stav98/UrsaMinor_CanSat-2018/Calculations/design2.jpg

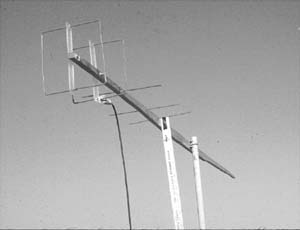
Calculations/design2.jpg
