stav98/UrsaMinor_CanSat-2018/Readme.md

Arduino folder contains nesessary libraries and hardware boads for compilation
Calculations folder contains spreadsheet calculations for parachute, antenna etc.
