stav98/UrsaMinor_CanSat-2018/Arduino/Readme.md

This is Arduino subfolder of MyDocuments folder. Unzip and append libraries and hardware folders.
To compile use tools/board MightyCore ATMEGA 1284 Board.
