stav98/UrsaMinor_CanSat-2018/Calculations/8lq.jpg

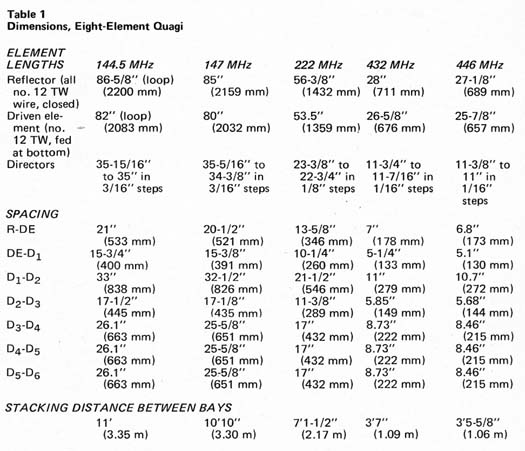
Calculations/8lq.jpg
