stav98/UrsaMinor_CanSat-2018/schematics/basestation.sch

## EAGLE design schematics/basestation.sch (2018-09-28)

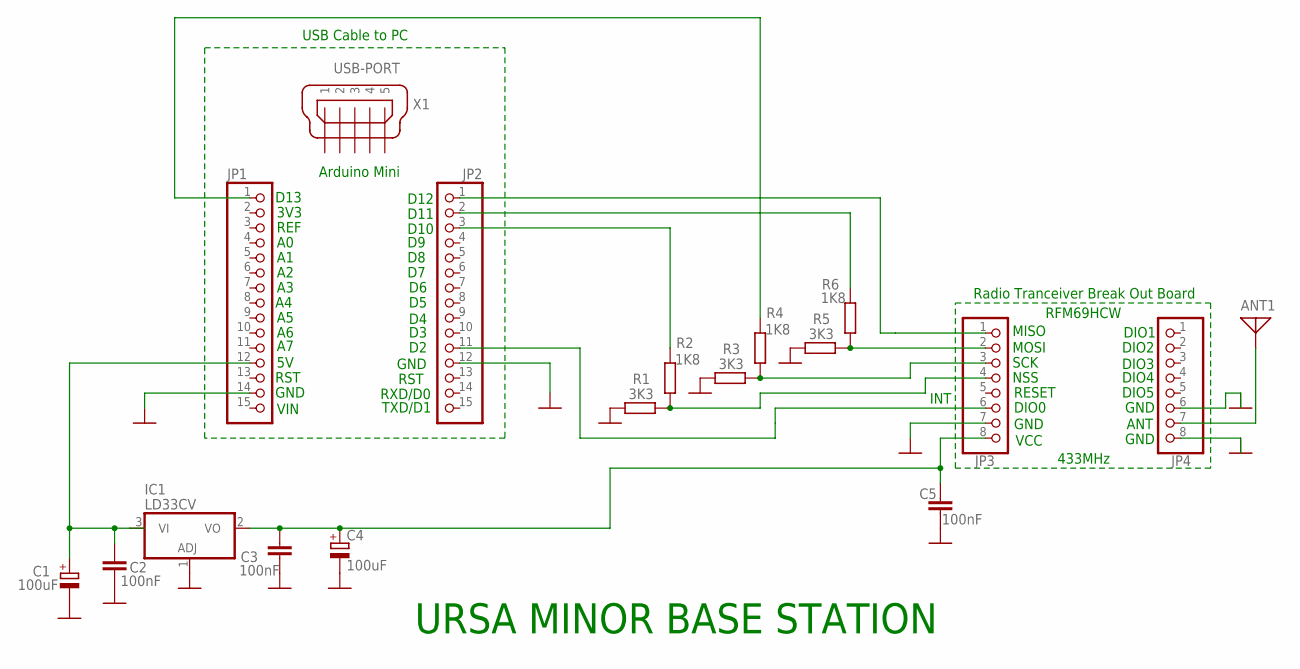
[picture p54: schematic basestation.sch]

Parts:
ANT1: ANTENNA; PAD-01
C1, C4: 100uF; E2,5-7
C2, C3, C5: 100nF; C2.5-2
IC1: LD33CV; TO220H
JP1, JP2: PINHD-1X15; 1X15
JP3, JP4: PINHD-1X8; 1X08
R1, R3, R5: 3K3; 0204V
R2, R4, R6: 1K8; 0204V
X1: USB-PORT; 32005-201

Connections:
GND: C1.-, C2.2, C3.2, C4.-, C5.1, IC1.1 (ADJ), JP1.14, JP2.12, JP3.7, JP4.6, R1.1, R3.1, R5.1
unnamed: JP2.11, JP3.6
unnamed: C1.+, C2.1, IC1.3 (VI), JP1.12
unnamed: C3.1, C4.+, C5.2, IC1.2 (VO), JP3.8
unnamed: ANT1.1, JP4.7
unnamed: JP3.2, R5.2, R6.1
unnamed: JP3.3, R3.2, R4.1
unnamed: JP3.4, R1.2, R2.1
unnamed: JP2.1, JP3.1
unnamed: JP2.2, R6.2
unnamed: JP1.1, R4.2
unnamed: JP2.3, R2.2

Notes on the sheet:
MISO
MOSI
SCK
NSS
RESET
DIO0
GND
VCC
DIO1
DIO2
DIO3
DIO4
DIO5
ANT
RFM69HCW
433MHz
Radio Tranceiver Break Out Board
INT
URSA MINOR BASE STATION
D13
3V3
REF
RST
VIN
D12
D11
D10
RXD/D0
TXD/D1
Arduino Mini
USB Cable to PC
