stav98/UrsaMinor_CanSat-2018/schematics/cansat_Pony_ser_ICSP.sch

## EAGLE design schematics/cansat_Pony_ser_ICSP.sch (2018-09-28)

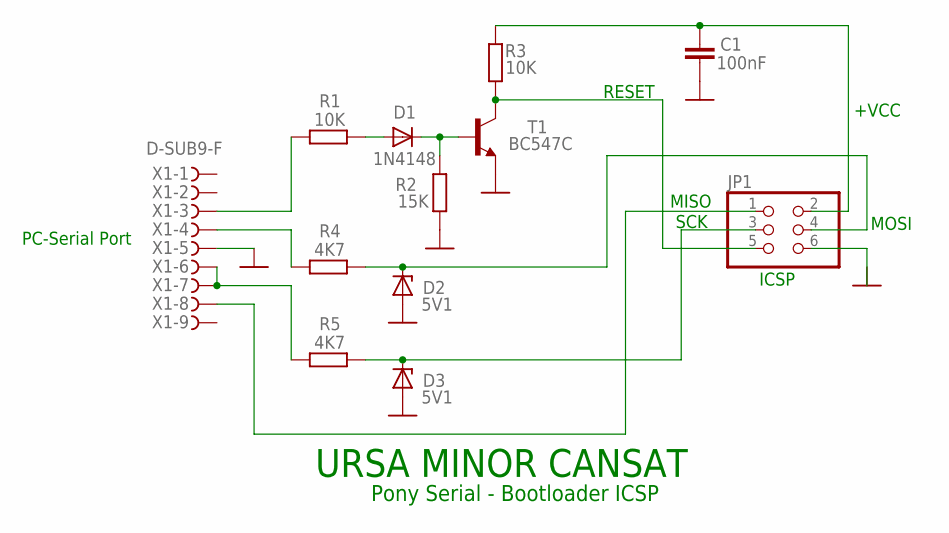
[picture p55: schematic cansat_Pony_ser_ICSP.sch]

Parts:
C1: 100nF; C2.5-2
D1: 1N4148; DO35-10
D2, D3: 5V1; SOD81
JP1: PINHD-2X3; 2X03
R1, R3: 10K; 0204V
R2: 15K; 0204V
R4, R5: 4K7; 0204V
T1: BC547C; TO92-CBE
X1: D-SUB9-F; H2M09RA

Connections:
GND: C1.2, D2.A, D3.A, R2.1, T1.E, X1.5
unnamed: JP1.5, R3.1, T1.C
unnamed: C1.1, JP1.2, R3.2
unnamed: JP1.1, X1.8
unnamed: R1.1, X1.3
unnamed: D1.A, R1.2
unnamed: D1.C, R2.2, T1.B
unnamed: R4.1, X1.4
unnamed: D2.C, JP1.4, R4.2
unnamed: R5.1, X1.6, X1.7
unnamed: D3.C, JP1.3, R5.2

Notes on the sheet:
MISO
SCK
RESET
+VCC
MOSI
ICSP
PC-Serial Port
URSA MINOR CANSAT
Pony Serial - Bootloader ICSP
