stav98/UrsaMinor_CanSat-2018/schematics/cansat_vehicle.sch

## EAGLE design schematics/cansat_vehicle.sch (2018-09-28)

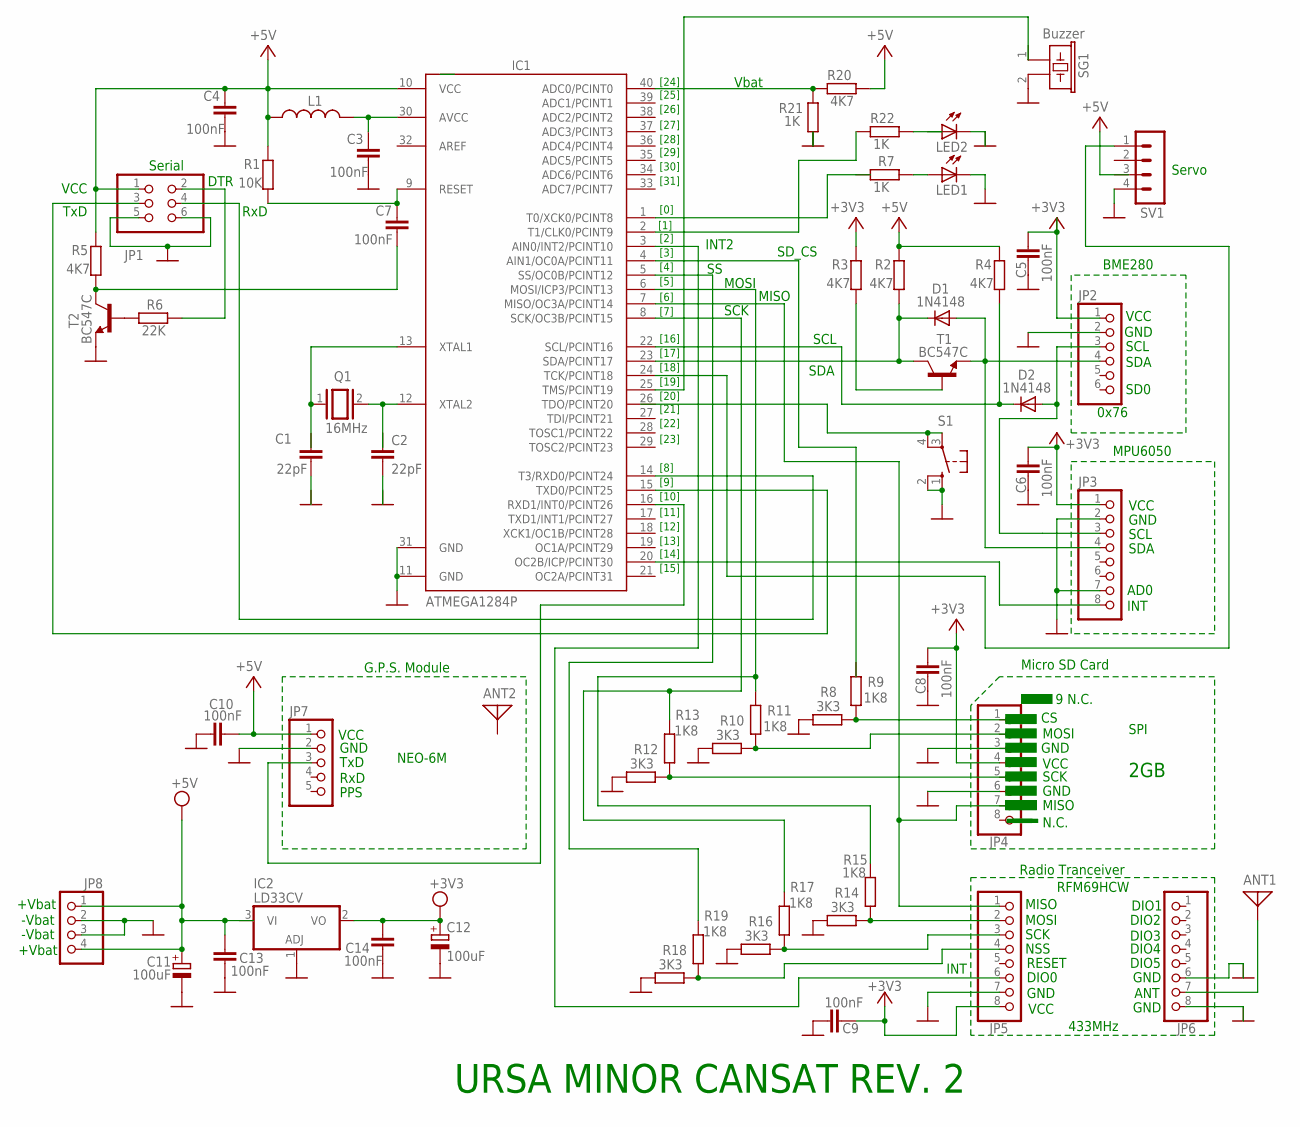
[picture p56: schematic cansat_vehicle.sch]

Parts:
ANT1, ANT2: ANTENNA; PAD-01
C1, C2: 22pF; C2.5-2
C3, C4, C5, C6, C7, C8, C9, C10, C13, C14: 100nF; C2.5-2
C11, C12: 100uF; E2,5-7
D1, D2: 1N4148; DO35-10
IC1: ATMEGA1284P; DIL40
IC2: LD33CV; TO220H
JP1: PINHD-2X3; 2X03
JP2: PINHD-1X6; 1X06
JP3, JP4, JP5, JP6: PINHD-1X8; 1X08
JP7: PINHD-1X5; 1X05
JP8: PINHD-1X4; 1X04
L1: L-US0204/5; 0204/5
LED1, LED2: LED3MM
Q1: 16MHz; Q
R1: 10K; 0204V
R2, R3, R4, R5, R20: 4K7; 0204V
R6: 22K; 0204V
R7, R21, R22: 1K; 0204V
R8, R10, R12, R14, R16, R18: 3K3; 0204V
R9, R11, R13, R15, R17, R19: 1K8; 0204V
S1: 10-XX; B3F-10XX
SG1: Buzzer; B/C11L
SV1: MA04-1
T1, T2: BC547C; TO92-CBE

Connections:
GND: C3.2, C4.2, C5.2, C6.2, C8.2, C9.1, C10.2, C11.-, C12.-, C13.2, C14.2, IC1.11 (GND), IC1.31 (GND), IC2.1 (ADJ), JP1.5, JP1.6, JP2.2, JP3.2, JP3.7, JP4.6, JP5.7, JP7.2, JP8.2, JP8.3, LED1.K (C), R8.1, R10.1, R12.1, R14.1, R16.1, R18.1, R21.1, S1.1 (S), S1.2 (S1), SG1.2, SV1.4, T2.E
unnamed: IC1.13 (XTAL1), Q1.1
unnamed: IC1.12 (XTAL2), Q1.2
unnamed: C3.1, IC1.30 (AVCC), L1.2
unnamed: D1.C, IC1.23 (SDA/PCINT17), R2.1, T1.C
unnamed: C7.1, IC1.9 (RESET), R1.1
unnamed: D1.A, JP2.4, JP3.4, T1.E
unnamed: R3.1, T1.B
unnamed: D2.C, IC1.22 (SCL/PCINT16), R4.1
unnamed: D2.A, JP2.3, JP3.3
unnamed: IC1.20 (OC2B/ICP/PCINT30), JP3.8
unnamed: R8.2, R9.1
unnamed: R10.2, R11.1
unnamed: C7.2, R5.1, T2.C
unnamed: R6.2, T2.B
unnamed: JP1.2, R6.1
unnamed: IC1.15 (TXD0/PCINT25), JP1.3
unnamed: IC1.14 (T3/RXD0/PCINT24), JP1.4
unnamed: IC1.1 (T0/XCK0/PCINT8), R7.2
unnamed: LED1.A, R7.1
unnamed: IC1.6 (MOSI/ICP3/PCINT13), R11.2, R15.2
unnamed: R12.2, R13.1
unnamed: IC1.8 (SCK/OC3B/PCINT15), R13.2, R17.2
unnamed: IC1.7 (MISO/OC3A/PCINT14), JP5.1
unnamed: ANT1.1, JP6.7
unnamed: JP5.2, R14.2, R15.1
unnamed: JP5.3, R16.2, R17.1
unnamed: IC1.2 (T1/CLK0/PCINT9), R22.2
unnamed: IC1.5 (SS/OC0B/PCINT12), R19.2
unnamed: IC1.3 (AIN0/INT2/PCINT10), JP5.6
unnamed: JP5.4, R18.2, R19.1
unnamed: IC1.16 (RXD1/INT0/PCINT26), JP7.3
unnamed: IC1.40 (ADC0/PCINT0), R20.2, R21.2
unnamed: S1.3, S1.4 (P1)
unnamed: IC1.24 (TCK/PCINT18), SV1.1
VCC: C4.1, C5.1, C6.1, C8.1, C9.2, C10.1, C11.+, C12.+, C13.1, C14.1, IC1.10 (VCC), IC2.2 (VO), JP1.1, JP2.1, JP3.1, JP4.4, JP5.8, JP7.1, JP8.1, JP8.4, L1.1, R1.2, R2.2, R3.2, R4.2, R5.2, R20.1

Notes on the sheet:
SCL
SDA
GND
VCC
SD0
0x76
BME280
AD0
INT
MPU6050
TxD
DTR
RxD
Serial
MOSI
SCK
MISO
N.C.
9 N.C.
SPI
2GB
Micro SD Card
SD_CS
NSS
RESET
DIO0
DIO1
DIO2
DIO3
DIO4
DIO5
ANT
RFM69HCW
433MHz
Radio Tranceiver
INT2
G.P.S. Module
NEO-6M
PPS
+Vbat
-Vbat
Vbat
[24]
[25]
[26]
[27]
[28]
[29]
[30]
[31]
[0]
[1]
[2]
[3]
[4]
[5]
[6]
[7]
[8]
[9]
[10]
[11]
[12]
[13]
[14]
[15]
[16]
[17]
[18]
[19]
[20]
[21]
[22]
[23]
URSA MINOR CANSAT REV. 2
Servo
