stav98/UrsaMinor_CanSat-2018/schematics/cansat_vehicle_v3_brd1.sch

## EAGLE design schematics/cansat_vehicle_v3_brd1.sch (2018-09-28)

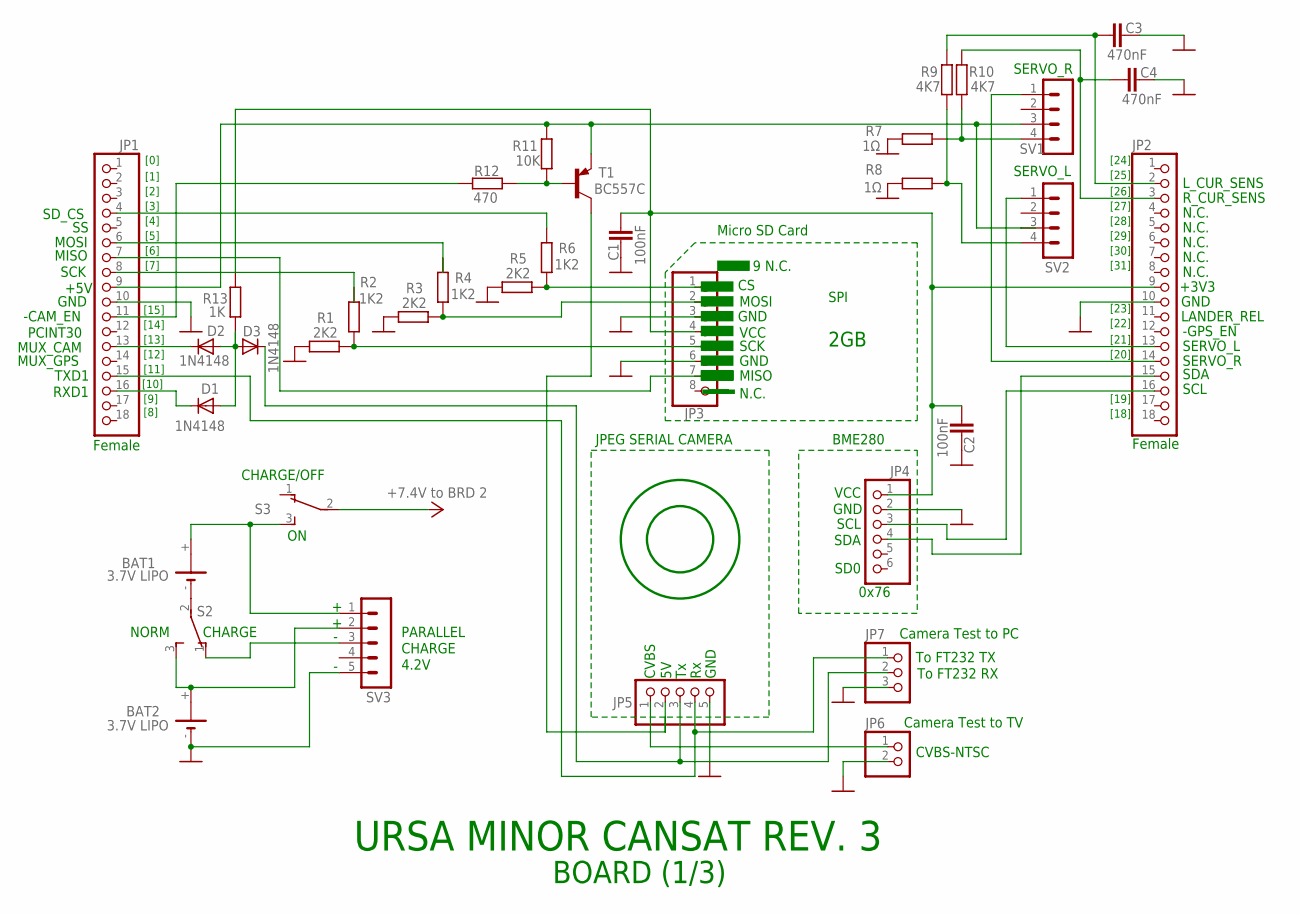
[picture p57: schematic cansat_vehicle_v3_brd1.sch]

Parts:
BAT1, BAT2: 3.7V LIPO; CRAA
C1, C2: 100nF; C2.5-2
C3, C4: 470nF; C2.5-2
D1, D2, D3: 1N4148; DO35-10
JP1, JP2: PINHD-1X18; 1X18
JP3: PINHD-1X8; 1X08
JP4: PINHD-1X6; 1X06
JP5: PINHD-1X5; 1X05
JP6: PINHD-1X2; 1X02
JP7: PINHD-1X3; 1X03
R1, R3, R5: 2K2; 0204V
R2, R4, R6: 1K2; 0204V
R7, R8: 1Ω; 0204V
R9, R10: 4K7; 0204V
R11: 10K; 0204V
R12: 470; 0204V
R13: 1K; 0204V
S2, S3: TL36WO; TL3XWO
SV1, SV2: MA04-1
SV3: MA05-1
T1: BC557C; TO92

Connections:
GND: BAT2.-, C1.2, C2.2, C3.2, C4.2, JP1.10, JP2.10, JP3.3, JP3.6, JP4.2, JP5.5, JP6.2, JP7.3, R1.1, R3.1, R5.1, R7.1, R8.1, SV3.5
unnamed: C1.1, C2.1, JP1.8, JP2.9, JP3.4, JP4.1, R13.2
unnamed: JP2.15, JP4.4
unnamed: R7.2, R10.1, SV1.4
unnamed: R8.2, R9.1, SV2.4
unnamed: C3.1, JP2.2, R9.2
unnamed: C4.1, JP2.3, R10.2
unnamed: R11.1, R12.1, T1.2 (B)
unnamed: JP1.11, R12.2
unnamed: D1.C, JP1.16
unnamed: D2.C, JP1.13
unnamed: D1.A, D2.A, D3.A, R13.1
unnamed: JP3.1, R5.2, R6.1
unnamed: JP1.4, R6.2
unnamed: JP3.2, R3.2, R4.1
unnamed: JP3.5, R1.2, R2.1
unnamed: JP2.13, SV2.1
unnamed: JP1.7, JP3.7
unnamed: JP2.14, SV1.1
unnamed: JP2.16, JP4.3
unnamed: JP1.9, R11.2, SV1.3, SV2.3, T1.1 (E)
unnamed: BAT1.-, S2.2
unnamed: BAT2.+, S2.3 (S), SV3.2
unnamed: BAT1.+, S3.3 (S), SV3.1
unnamed: S2.1 (O), SV3.3
unnamed: JP5.1, JP6.1
unnamed: D3.C, JP5.3, JP7.2
unnamed: JP1.15, JP5.4, JP7.1
VCC: S3.2

Notes on the sheet:
SCL
SDA
MOSI
SCK
MISO
[24]
[25]
[26]
[27]
[28]
[29]
[30]
[31]
[0]
[1]
[2]
[3]
[4]
[5]
[6]
[7]
[8]
[9]
[10]
[11]
[12]
[13]
[14]
[15]
[18]
[19]
[20]
[21]
[22]
[23]
Female
+5V
GND
+3V3
URSA MINOR CANSAT REV. 3
BOARD (1/3)
VCC
N.C.
9 N.C.
SPI
2GB
Micro SD Card
SD_CS
SD0
0x76
BME280
SERVO_R
SERVO_L
PARALLEL
CHARGE
4.2V
CHARGE/OFF
NORM
CVBS
RXD1
TXD1
JPEG SERIAL CAMERA
CVBS-NTSC
L_CUR_SENS
R_CUR_SENS
-CAM_EN
MUX_CAM
To FT232 TX
To FT232 RX
Camera Test to PC
Camera Test to TV
MUX_GPS
-GPS_EN
PCINT30
LANDER_REL
