stav98/UrsaMinor_CanSat-2018/schematics/cansat_vehicle_v3_brd2.sch

## EAGLE design schematics/cansat_vehicle_v3_brd2.sch (2018-09-28)

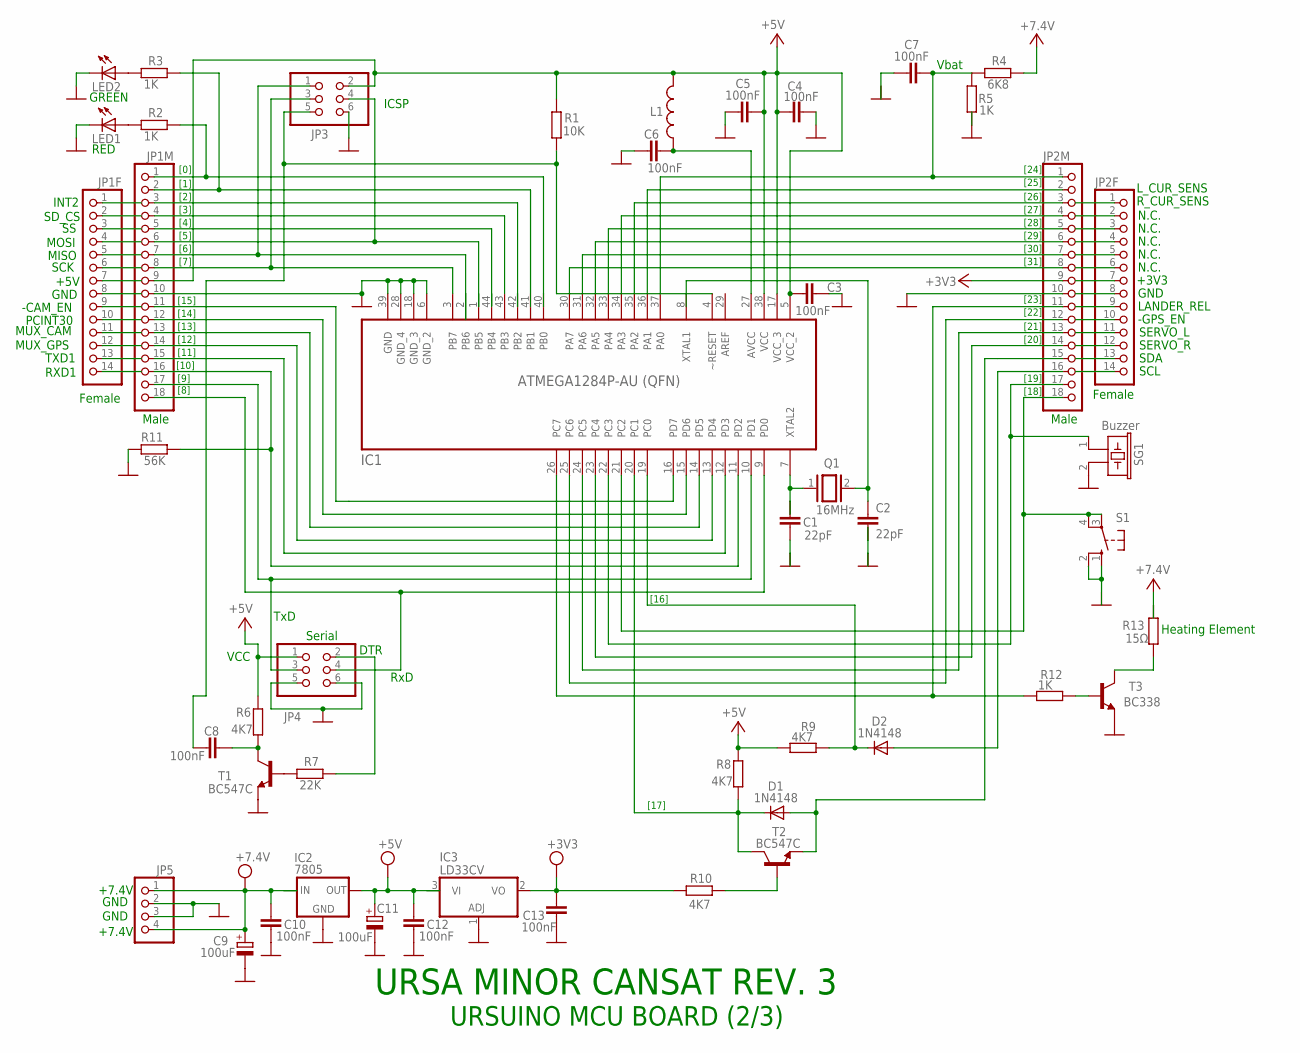
[picture p58: schematic cansat_vehicle_v3_brd2.sch]

Parts:
C1, C2: 22pF; C2.5-2
C3, C4, C5, C6, C7, C8, C10, C12, C13: 100nF; C2.5-2
C9, C11: 100uF; E2,5-7
D1, D2: 1N4148; DO35-10
IC1: ATMEGA1284P-AU (QFN); QFP80P1200X1200X120-44N
IC2: 7805; 78XXL
IC3: LD33CV; TO220H
JP1F, JP2F: PINHD-1X14; 1X14
JP1M, JP2M: PINHD-1X18; 1X18
JP3, JP4: PINHD-2X3; 2X03
JP5: PINHD-1X4; 1X04
L1: L-US0204/5; 0204/5
LED1, LED2: LED3MM
Q1: 16MHz; Q
R1: 10K; 0204V
R2, R3, R5, R12: 1K; 0204V
R4: 6K8; 0204V
R6, R8, R9, R10: 4K7; 0204V
R7: 22K; 0204V
R11: 56K; 0204V
R13: 15Ω; 0204V
S1: 10-XX; B3F-10XX
SG1: Buzzer; B/C11L
T1, T2: BC547C; TO92-CBE
T3: BC338; TO92-CBE

Connections:
GND: C1.2, C2.2, C3.2, C4.1, C5.2, C6.1, C9.-, C10.2, C11.-, C12.2, C13.2, IC1.6 (GND_2), IC1.18 (GND_3), IC1.28 (GND_4), IC1.39 (GND), IC2.GND, IC3.1 (ADJ), JP1M.10, JP2M.10, JP3.6, JP4.5, JP4.6, JP5.2, JP5.3, LED1.K (C), LED2.K (C), R5.1, R11.2, SG1.2, T1.E, T3.E
unnamed: C1.1, IC1.7 (XTAL2), Q1.1
unnamed: IC1.15 (PD6), JP1M.12
unnamed: IC1.14 (PD5), JP1M.13
unnamed: C2.1, IC1.8 (XTAL1), Q1.2
unnamed: R12.1, T3.B
unnamed: R13.1, T3.C
unnamed: IC1.40 (PB0), JP1M.1, R2.1
unnamed: IC1.41 (PB1), JP1M.2, R3.1
unnamed: IC1.42 (PB2), JP1M.3
unnamed: IC1.43 (PB3), JP1M.4
unnamed: IC1.44 (PB4), JP1M.5
unnamed: IC1.1 (PB5), JP1M.6, JP3.4
unnamed: IC1.2 (PB6), JP1M.7, JP3.1
unnamed: IC1.3 (PB7), JP1M.8, JP3.3
unnamed: IC1.16 (PD7), JP1M.11
unnamed: IC1.13 (PD4), JP1M.14
unnamed: IC1.12 (PD3), JP1M.15
unnamed: IC1.11 (PD2), JP1M.16, R11.1
unnamed: IC1.10 (PD1), JP1M.17, JP4.3
unnamed: R10.1, T2.B
unnamed: IC1.36 (PA1), JP2M.2
unnamed: IC1.35 (PA2), JP2M.3
unnamed: IC1.34 (PA3), JP2M.4
unnamed: IC1.33 (PA4), JP2M.5
unnamed: IC1.32 (PA5), JP2M.6
unnamed: IC1.31 (PA6), JP2M.7
unnamed: IC1.30 (PA7), JP2M.8
unnamed: IC1.21 (PC2), JP2M.18, S1.3, S1.4 (P1)
unnamed: IC1.22 (PC3), JP2M.17, SG1.1
unnamed: D2.A, JP2M.16
unnamed: D1.C, IC1.20 (PC1), R8.1, T2.C
unnamed: IC1.23 (PC4), JP2M.14
unnamed: IC1.24 (PC5), JP2M.13
unnamed: IC1.25 (PC6), JP2M.12
unnamed: IC1.26 (PC7), JP2M.11, R12.2
unnamed: D1.A, JP2M.15, T2.E
unnamed: LED1.A, R2.2
unnamed: D2.C, IC1.19 (PC0), R9.1
unnamed: C6.2, IC1.27 (AVCC), L1.1
unnamed: C8.1, IC1.4 (~RESET), JP3.5, R1.1
unnamed: LED2.A, R3.2
unnamed: S1.1 (S), S1.2 (S1)
unnamed: C7.1, IC1.37 (PA0), JP2M.1, R4.2, R5.2
unnamed: C8.2, R6.1, T1.C
unnamed: R7.2, T1.B
unnamed: JP4.2, R7.1
unnamed: IC1.9 (PD0), JP1M.18, JP4.4
VCC: C3.1, C4.2, C5.1, C9.+, C10.1, C11.+, C12.1, C13.1, IC1.5 (VCC_2), IC1.17 (VCC_3), IC1.38 (VCC), IC2.IN, IC2.OUT, IC3.2 (VO), IC3.3 (VI), JP1M.9, JP2M.9, JP3.2, JP4.1, JP5.1, JP5.4, L1.2, R1.2, R4.1, R6.2, R8.2, R9.2, R10.2

Notes on the sheet:
SCL
SDA
MOSI
SCK
MISO
SD_CS
[24]
[25]
[26]
[27]
[28]
[29]
[30]
[31]
[0]
[1]
[2]
[3]
[4]
[5]
[6]
[7]
[8]
[9]
[10]
[11]
[12]
[13]
[14]
[15]
[16]
[17]
[18]
[19]
[20]
[21]
[22]
[23]
TxD
VCC
DTR
RxD
Serial
ICSP
Male
Female
+7.4V
GND
RED
GREEN
+5V
+3V3
Vbat
URSA MINOR CANSAT REV. 3
URSUINO MCU BOARD (2/3)
INT2
SERVO_R
SERVO_L
LANDER_REL
Heating Element
RXD1
TXD1
-CAM_EN
PCINT30
MUX_CAM
MUX_GPS
-GPS_EN
L_CUR_SENS
R_CUR_SENS
N.C.
