stav98/UrsaMinor_CanSat-2018/schematics/cansat_vehicle_v3_brd3.sch

## EAGLE design schematics/cansat_vehicle_v3_brd3.sch (2018-09-28)

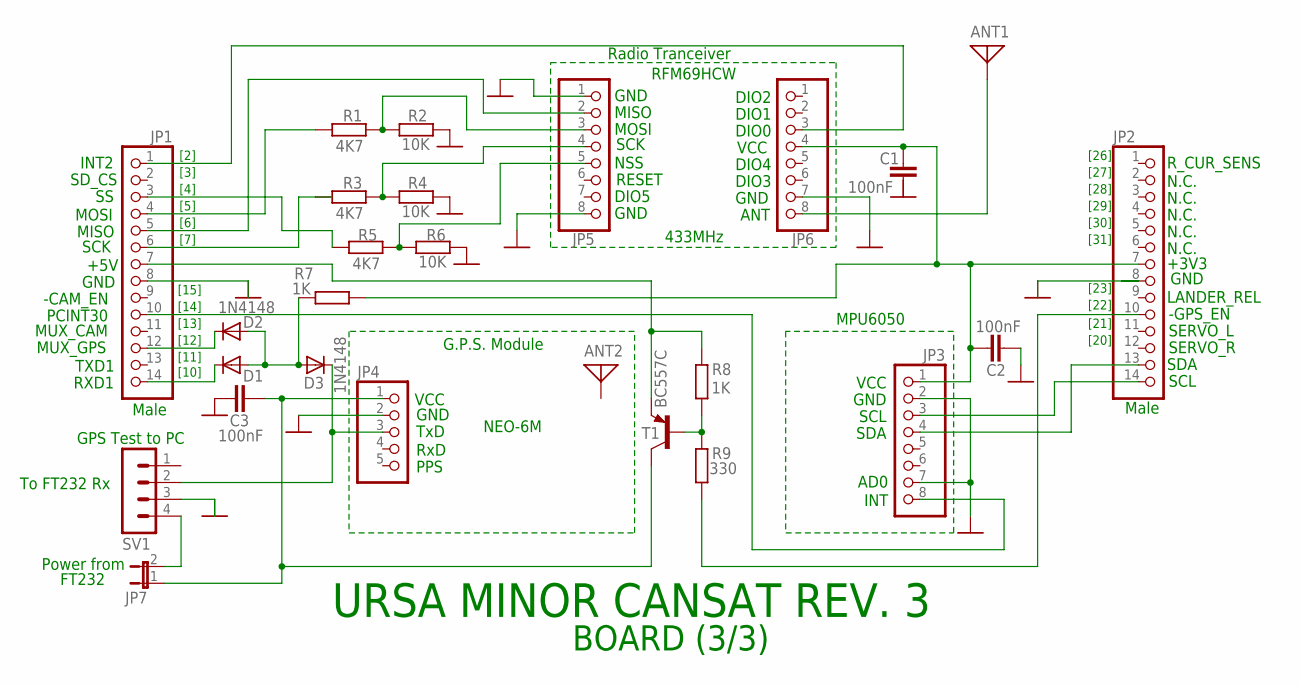
[picture p59: schematic cansat_vehicle_v3_brd3.sch]

Parts:
ANT1, ANT2: ANTENNA; PAD-01
C1, C2, C3: 100nF; C2.5-2
D1: 1N4148DO35-10; DO35-10
D2, D3: 1N4148; DO35-10
JP1, JP2: PINHD-1X14; 1X14
JP3, JP5, JP6: PINHD-1X8; 1X08
JP4: PINHD-1X5; 1X05
JP7: JP1E; JP1
R1, R3, R5: 4K7; 0204V
R2, R4, R6: 10K; 0204V
R7, R8: 1K; 0204V
R9: 330; 0204V
SV1: MA04-1
T1: BC557C; TO92

Connections:
GND: C2.2, C3.2, JP3.2, JP3.7, JP4.2, JP5.1, JP5.8, JP6.7, R2.2, R4.2, R6.2
unnamed: D3.C, JP4.3, SV1.2
unnamed: JP7.2, SV1.4
unnamed: C3.1, JP4.1, JP7.1, T1.3 (C)
unnamed: D1.C, JP1.14
unnamed: D2.C, JP1.12
unnamed: D1.A, D2.A, D3.A, R7.2
unnamed: JP1.7, R8.1, T1.1 (E)
unnamed: R8.2, R9.1, T1.2 (B)
unnamed: JP2.10, R9.2
unnamed: ANT1.1, JP6.8
unnamed: JP1.6, R3.2
unnamed: JP1.3, R5.2
unnamed: JP1.1, JP6.3
unnamed: JP5.5, R5.1, R6.1
unnamed: JP2.14, JP3.3
unnamed: JP1.5, JP5.2
unnamed: JP1.4, R1.2
unnamed: JP5.4, R3.1, R4.1
unnamed: JP5.3, R1.1, R2.1
unnamed: JP2.13, JP3.4
unnamed: JP1.10, JP3.8
VCC: C1.2, C2.1, JP2.7, JP3.1, JP6.4, R7.1

Notes on the sheet:
SCL
SDA
VCC
GND
AD0
INT
MPU6050
MOSI
SCK
MISO
SD_CS
NSS
RESET
DIO0
DIO1
DIO2
DIO3
DIO4
DIO5
ANT
RFM69HCW
433MHz
Radio Tranceiver
G.P.S. Module
NEO-6M
TxD
RxD
PPS
[26]
[27]
[28]
[29]
[30]
[31]
[2]
[3]
[4]
[5]
[6]
[7]
[10]
[11]
[12]
[13]
[14]
[15]
[20]
[21]
[22]
[23]
Male
+5V
+3V3
URSA MINOR CANSAT REV. 3
BOARD (3/3)
INT2
GPS Test to PC
To FT232 Rx
PCINT30
-GPS_EN
RXD1
TXD1
MUX_GPS
MUX_CAM
-CAM_EN
SERVO_L
SERVO_R
LANDER_REL
R_CUR_SENS
Power from
FT232
N.C.
