stav98/UrsaMinor_CanSat-2018/src/cansat_rover_V3/bme280.h

#include "SparkFunBME280.h"

void bme280_init(void);
void bme280_status(void);

BME280 mySensor;

void bme280_init()
{
  mySensor.settings.commInterface = I2C_MODE;
  mySensor.settings.I2CAddress = 0x76;
  //renMode can be:
  //  0, Sleep mode
  //  1 or 2, Forced mode
  //  3, Normal mode
  mySensor.settings.runMode = 3; //Normal mode

  //tStandby can be:
  //  0, 0.5ms
  //  1, 62.5ms
  //  2, 125ms
  //  3, 250ms
  //  4, 500ms
  //  5, 1000ms
  //  6, 10ms
  //  7, 20ms
  mySensor.settings.tStandby = 0;

  //filter can be off or number of FIR coefficients to use:
  //  0, filter off
  //  1, coefficients = 2
  //  2, coefficients = 4
  //  3, coefficients = 8
  //  4, coefficients = 16
  mySensor.settings.filter = 0;

  //tempOverSample can be:
  //  0, skipped
  //  1 through 5, oversampling *1, *2, *4, *8, *16 respectively
  mySensor.settings.tempOverSample = 1;

  //pressOverSample can be:
  //  0, skipped
  //  1 through 5, oversampling *1, *2, *4, *8, *16 respectively
    mySensor.settings.pressOverSample = 1;
  
  //humidOverSample can be:
  //  0, skipped
  //  1 through 5, oversampling *1, *2, *4, *8, *16 respectively
  mySensor.settings.humidOverSample = 1;
  byte bme_status = mySensor.begin();
  if (bme_status > 0)
     {
      Serial.print(F("BME280 Sensor OK with code: "));
      Serial.println(bme_status, HEX);
      bitSet(hw_status, BME280SENS);
     }
  else
     Serial.println(F("BME280 not found.")); 
}


void bme280_status()
{
  Serial.print("Displaying ID, reset and ctrl regs\n");
  Serial.print("ID(0xD0): 0x");
  Serial.println(mySensor.readRegister(BME280_CHIP_ID_REG), HEX);
  Serial.print("Reset register(0xE0): 0x");
  Serial.println(mySensor.readRegister(BME280_RST_REG), HEX);
  Serial.print("ctrl_meas(0xF4): 0x");
  Serial.println(mySensor.readRegister(BME280_CTRL_MEAS_REG), HEX);
  Serial.print("ctrl_hum(0xF2): 0x");
  Serial.println(mySensor.readRegister(BME280_CTRL_HUMIDITY_REG), HEX);
  Serial.print("\n\n");
  Serial.print("Displaying all regs\n");
  uint8_t memCounter = 0x80;
  uint8_t tempReadData;
  for(int rowi = 8; rowi < 16; rowi++ )
     {
      Serial.print("0x");
      Serial.print(rowi, HEX);
      Serial.print("0:");
      for(int coli = 0; coli < 16; coli++ )
         {
          tempReadData = mySensor.readRegister(memCounter);
          Serial.print((tempReadData >> 4) & 0x0F, HEX);//Print first hex nibble
          Serial.print(tempReadData & 0x0F, HEX);//Print second hex nibble
          Serial.print(" ");
          memCounter++;
         }
      Serial.print("\n");
     }
  Serial.print("\n\n");
  Serial.print("Displaying concatenated calibration words\n");
  Serial.print("dig_T1, uint16: ");
  Serial.println(mySensor.calibration.dig_T1);
  Serial.print("dig_T2, int16: ");
  Serial.println(mySensor.calibration.dig_T2);
  Serial.print("dig_T3, int16: ");
  Serial.println(mySensor.calibration.dig_T3);
  Serial.print("dig_P1, uint16: ");
  Serial.println(mySensor.calibration.dig_P1);
  Serial.print("dig_P2, int16: ");
  Serial.println(mySensor.calibration.dig_P2);
  Serial.print("dig_P3, int16: ");
  Serial.println(mySensor.calibration.dig_P3);
  Serial.print("dig_P4, int16: ");
  Serial.println(mySensor.calibration.dig_P4);
  Serial.print("dig_P5, int16: ");
  Serial.println(mySensor.calibration.dig_P5);
  Serial.print("dig_P6, int16: ");
  Serial.println(mySensor.calibration.dig_P6);
  Serial.print("dig_P7, int16: ");
  Serial.println(mySensor.calibration.dig_P7);
  Serial.print("dig_P8, int16: ");
  Serial.println(mySensor.calibration.dig_P8);
  Serial.print("dig_P9, int16: ");
  Serial.println(mySensor.calibration.dig_P9);
  Serial.print("dig_H1, uint8: ");
  Serial.println(mySensor.calibration.dig_H1);
  Serial.print("dig_H2, int16: ");
  Serial.println(mySensor.calibration.dig_H2);
  Serial.print("dig_H3, uint8: ");
  Serial.println(mySensor.calibration.dig_H3);
  Serial.print("dig_H4, int16: ");
  Serial.println(mySensor.calibration.dig_H4);
  Serial.print("dig_H5, int16: ");
  Serial.println(mySensor.calibration.dig_H5);
  Serial.print("dig_H6, uint8: ");
  Serial.println(mySensor.calibration.dig_H6);
  Serial.println();
}
